CycloneCanSat/Random-Files/18.PNG

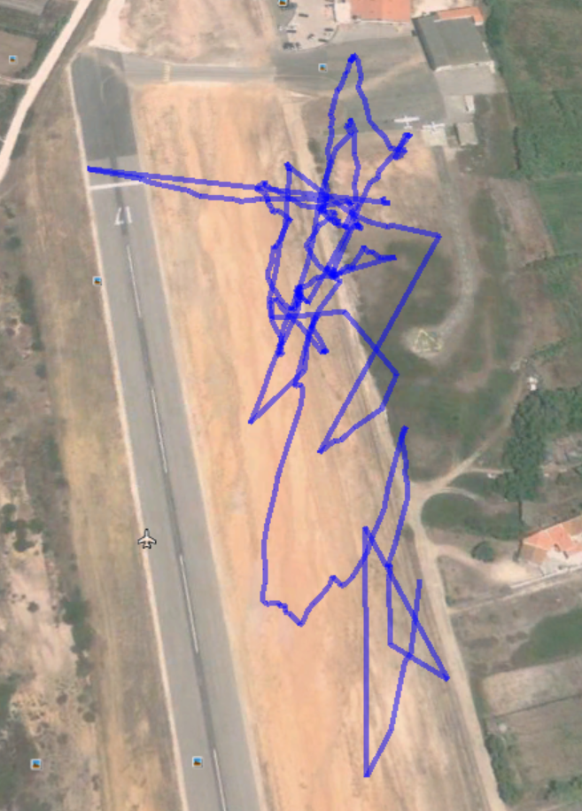
18.PNG
