CycloneCanSat/Random-Files/photo_2015-06-19_02-48-39.jpg

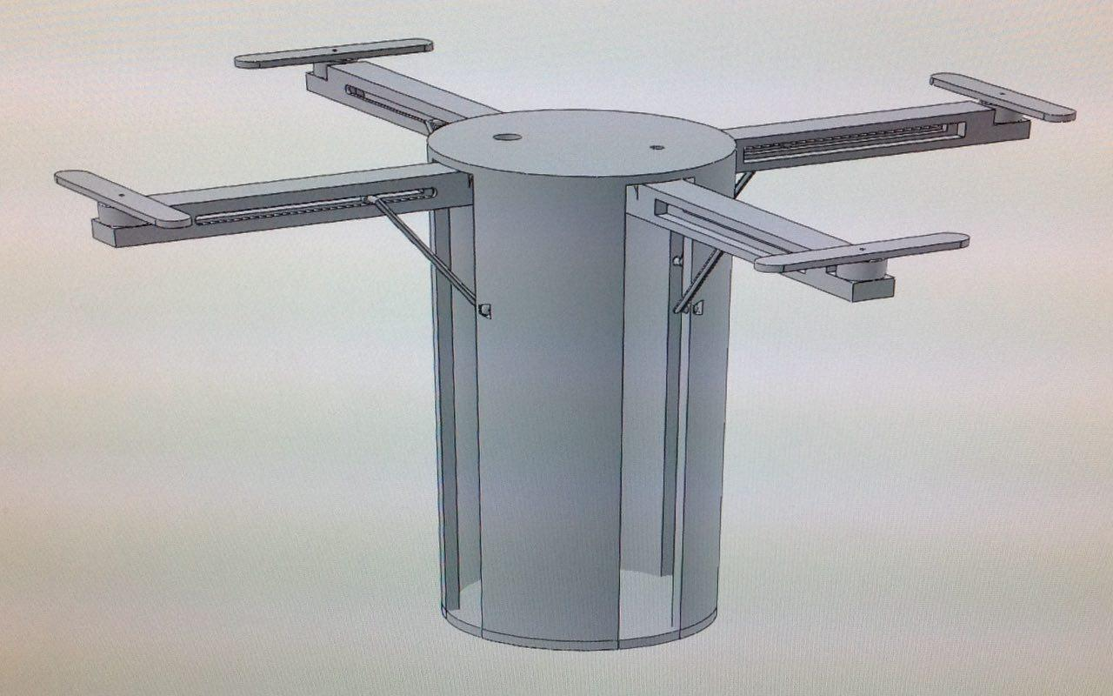
photo_2015-06-19_02-48-39.jpg
