CycloneCanSat/Random-Files/README.md

# Random-Files
These are random files from the Cyclone Team
