CycloneCanSat/Random-Files/Presentation2.pptx

Motor 4

ESC 1

IMU

Power Distribution Board

Main PCB

Motor 3

ESC 2

GPS

Motor 2

ESC 3

Battery

Mini FPV Camera

Humidity Sensor

Pressure Sensor

Motor 1

ESC 4

OSD

Control Board

FPV TX

Radio RX
