CycloneCanSat/Random-Files/Gantt Chart.docx

| | | | | | | | | | | | | | | | | | | | | | LAUNCH WEEK
| Week Commencing: | 19/10/2015 | 26/10/2015 | 02/11/2015 | 09/11/2015 | 16/11/2015 | 23/11/2015 | 30/11/2015 | 07/12/2015 | 14/12/2015 | 28/12/2015 | 04/01/2016 | 11/01/2016 | 18/01/2016 | 25/01/2016 | 01/02/2016 | 08/02/2016 | 15/02/2016 | 22/02/2016 | 29/02/2016 | 07/03/2016 | 14/03/2016 | 21/03/2016 | 28/03/2016
Electronics
| Sensor PCB design
| Sensor PCB assembly
| Quadcopter electronics assembly
| Camera system assembly
| Full can assembly
Software
| Write libraries for sensor
| Write libraries for RF98W
| Write Can code
Mechanics
| Layer design (using CAD)
| Arm design (using CAD)
| Layer manufacture (using 3D printing)
| Arm manufacture (using 3D printing)
| Manufacture of arm opening system
| Can assembly
Testing
| PCB testing
| Quadcopter system testing
| Camera system testing
| Full electronics testing
| Test arm opening
| Flight test
| Launch procedure testing
Outreach
| iOS app design
| Fundraising
| Talks to primary school students
| Inside school promotion
Base Station
| Software
| Communications system design
| Base station electronics design
| Base station electronics manufacture
Paperwork
| Progress Reports
| Submission of documentation to sponsors
