CycloneCanSat/Random-Files/hobbyking.pdf

Name | Quantity Cost per Unit Link | Sub-Total
Turnigy Nano-Tech 850mAh LiPo | 4 £ | 6.56 http://www.hobbyking.co.uk/hobbyking/store/__18203__Turnigy_nano_tech_850mAh_3S_45_90C_Lipo_Pack.html | £ 26.24
Hobbyking i8 Control Board | 1 £ 10.98 http://www.hobbyking.co.uk/hobbyking/store/__12974__Hobbyking_i86_Multi_Rotor_Control_Board.html | £ 10.98
Turnigy Multistar Outrunner V2 Motors | 6 £ | 7.46 http://www.hobbyking.co.uk/hobbyking/store/__66414__Turnigy_Multistar_1704_1900Kv_12_Pole_Multi_Rotor_Outrunner_V2.htmlv | £ 44.76
Turnigy Multistar 20A Slim ESCs | 6 £ | 8.88 http://www.hobbyking.com/hobbyking/store/__65154__Turnigy_Multistar_20A_Slim_V2_ESC_With_BLHeli_OPTO_2_6S.html | £ 53.28
Turnigy Analog Nano Servos | 6 £ | 2.55 http://www.hobbyking.com/hobbyking/store/__28280__Turnigy_8482_TGY_TS531A_Analog_Nano_Servo_0_5kg_0_12sec_3_7g.html | £ 15.30
Hobbyking FPV Transmitter | 2 £ 13.35 http://hobbyking.com/hobbyking/store/__76392__HobbyKing_8482_FT952_5_8GHz_32CH_200mW_Mini_FPV_Transmitter_with_Gopro_3_AV_Lead.html | £ 26.70
Turnigy 2200mAh battery (for base station) | 2 £ | 6.39 http://hobbyking.com/hobbyking/store/__8932__Turnigy_2200mAh_3S_20C_Lipo_Pack.html | £ 12.78
SkyZone FPV receiver | 2 £ 12.77 http://hobbyking.com/hobbyking/store/__18649__SkyZone_RC805_5_8Ghz_8_Channel_AV_Receiver.html | £ 25.54
Polarized SMA antenna | 2 £ | 3.19 http://hobbyking.com/hobbyking/store/__43700__5_8GHz_Circular_Polarized_Antenna_SMA_Set_Short_.html | £ 6.38
SMA wire | 5 £ | 1.06 http://hobbyking.com/hobbyking/store/uh_viewItem.asp?idProduct=50463 | £ 5.30
Hobbyking OSD | 2 £ | 9.28 http://hobbyking.com/hobbyking/store/__16662__HobbyKing_E_OSD.html | £ 18.56
Mini FPV Camera | 2 £ 18.84 http://hobbyking.com/hobbyking/store/__64444__Mini_CMOS_FPV_Camera_520TVL_90_deg_Field_Of_Vision_0_008LUX_11_5_x_11_5_x_21mm_PAL_.html | £ 37.68
Lipol Bags | 6 £ | 1.34 http://hobbyking.com/hobbyking/store/__27105__Lipoly_Charge_Bag_23_x_30cm.html | £ 8.04
Orange Radio Transmitter | 1 £ 41.59 http://www.hobbyking.co.uk/hobbyking/store/__54822__OrangeRx_T_SIX_2_4GHz_DSM2_Compatible_6CH_Transmitter_w_10_Model_Memory_and_3_Pos_Switch_Mode_2_.html | £ 41.59
Orange Radio Receiver | 2 £ | 6.97 http://www.hobbyking.co.uk/hobbyking/store/__61211__OrangeRx_R410X_DSMX_Compatible_4Ch_6CH_PWM_CPPM_2_4Ghz_Receiver_.html | £ 13.94
Hobbyking LiPo charger | 1 £ | 7.98 http://hobbyking.com/hobbyking/store/__21044__Hobbyking_174_DC_4S_Balance_Charger_Cell_Checker_30w_2s_4s.html | £ 7.98
TOTAL | £ 355.05
