CycloneCanSat/Random-Files/13.PNG

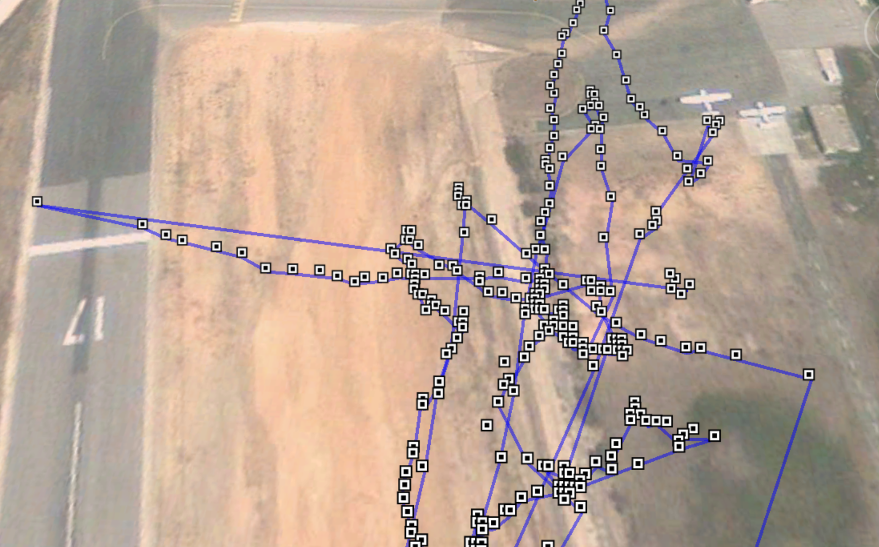
13.PNG
