CycloneCanSat/Random-Files/14.PNG

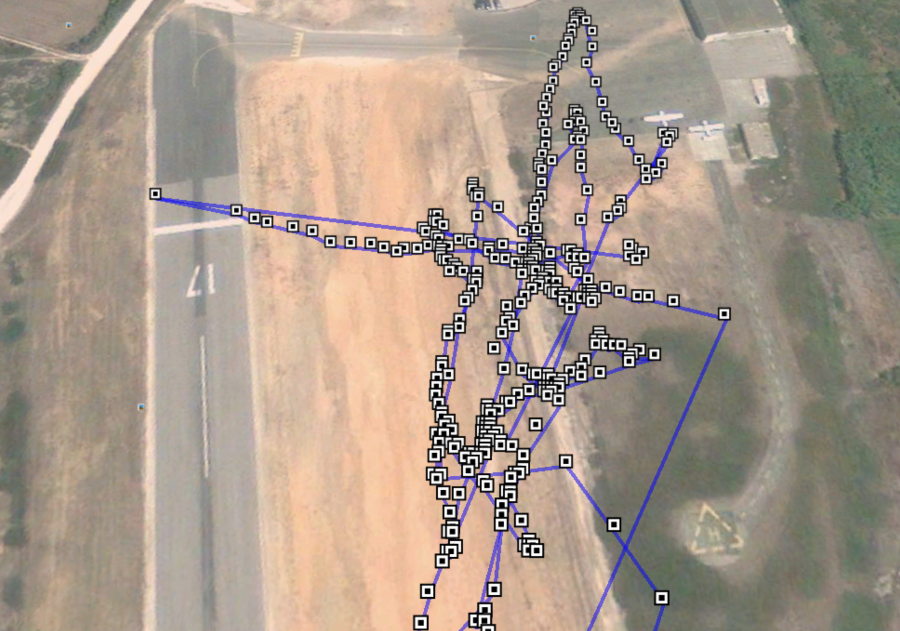
14.PNG
