CycloneCanSat/Random-Files/15.PNG

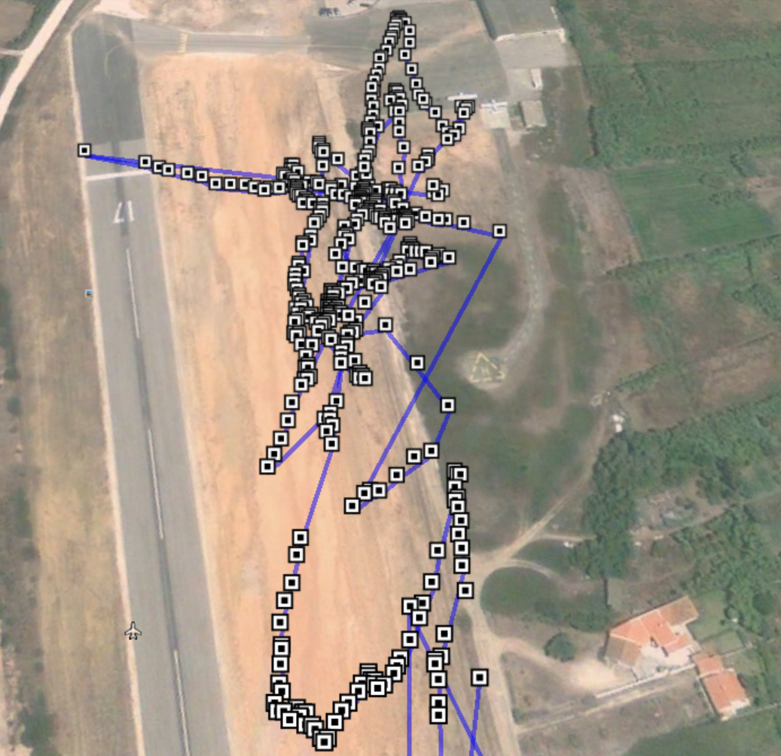
15.PNG
