CycloneCanSat/Random-Files/16.PNG

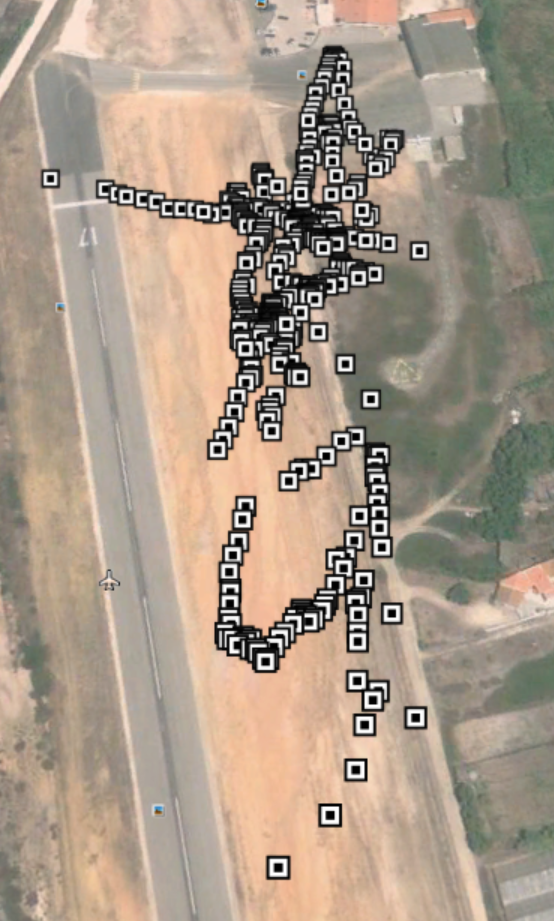
16.PNG
