CycloneCanSat/Random-Files/17.PNG

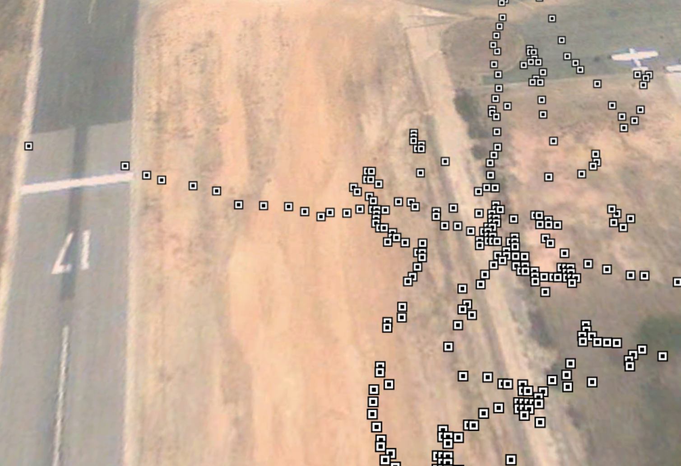
17.PNG
