CycloneCanSat/Random-Files/19.PNG

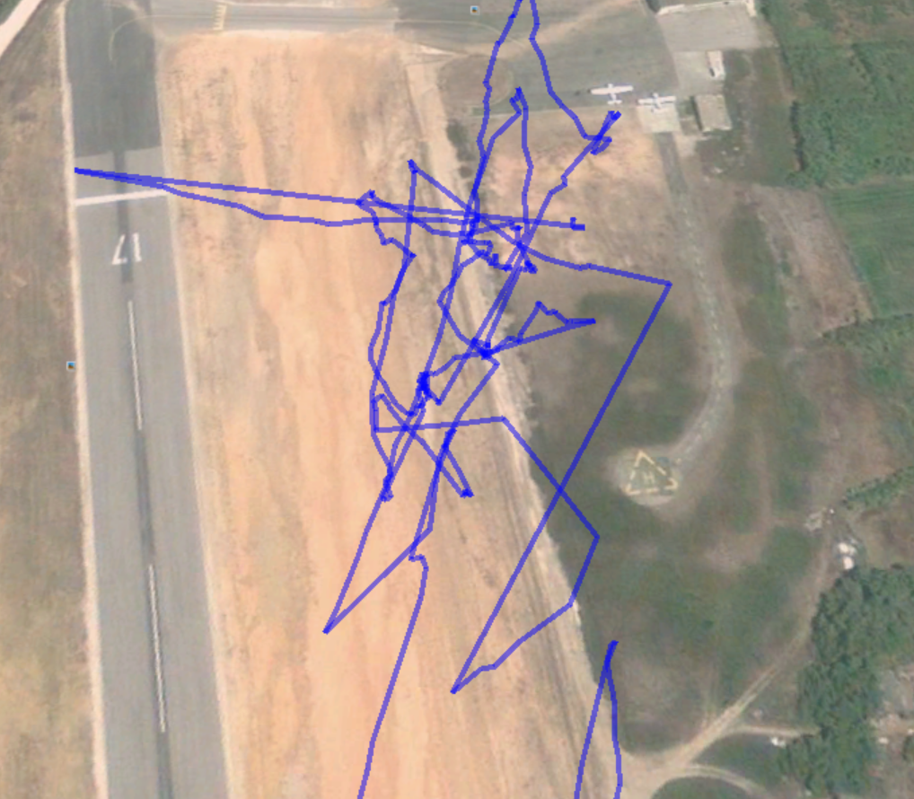
19.PNG
