CycloneCanSat/Random-Files/22.PNG

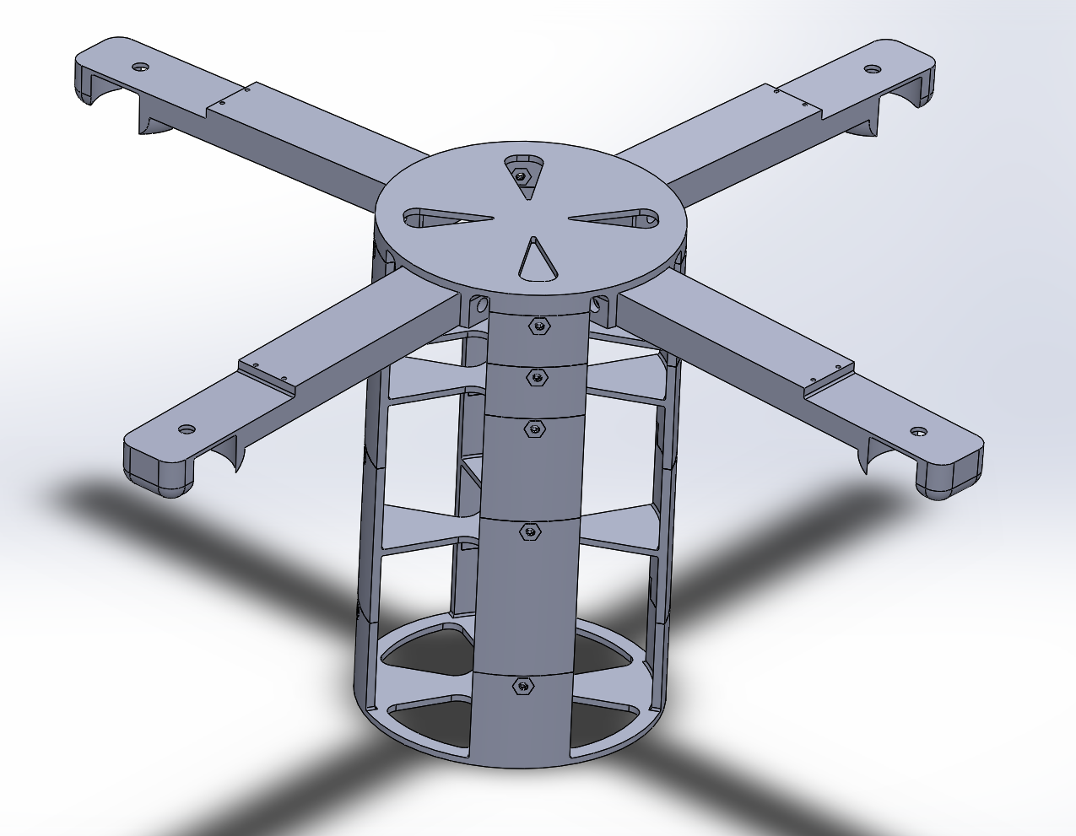
22.PNG
