CycloneCanSat/Random-Files/23.PNG

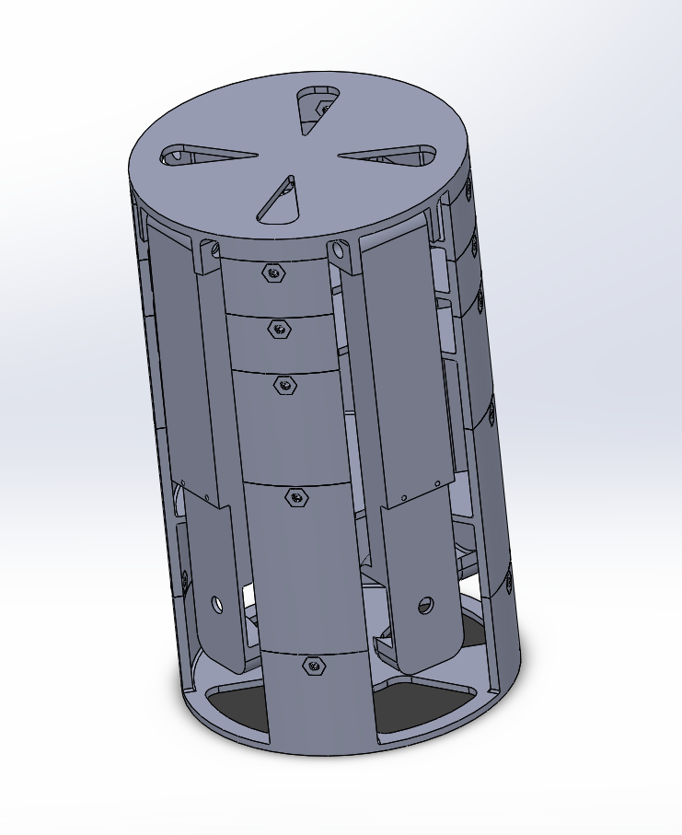
23.PNG
