CycloneCanSat/Random-Files/24.PNG

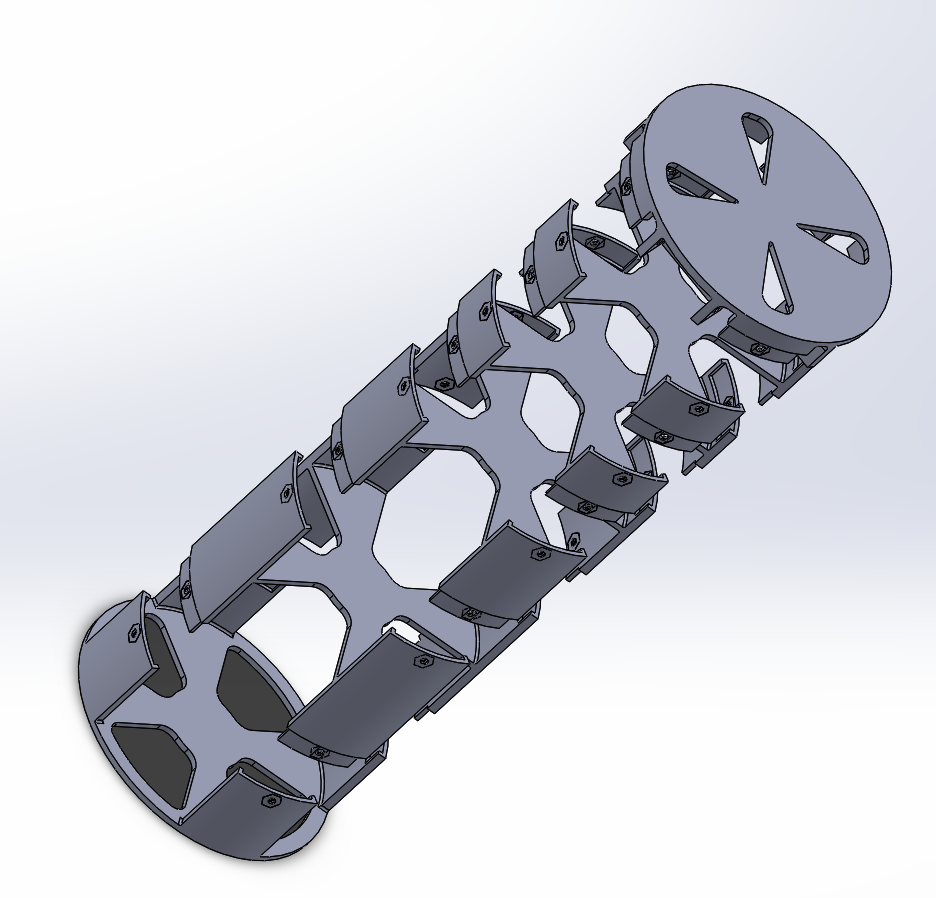
24.PNG
