CycloneCanSat/Random-Files/25.PNG

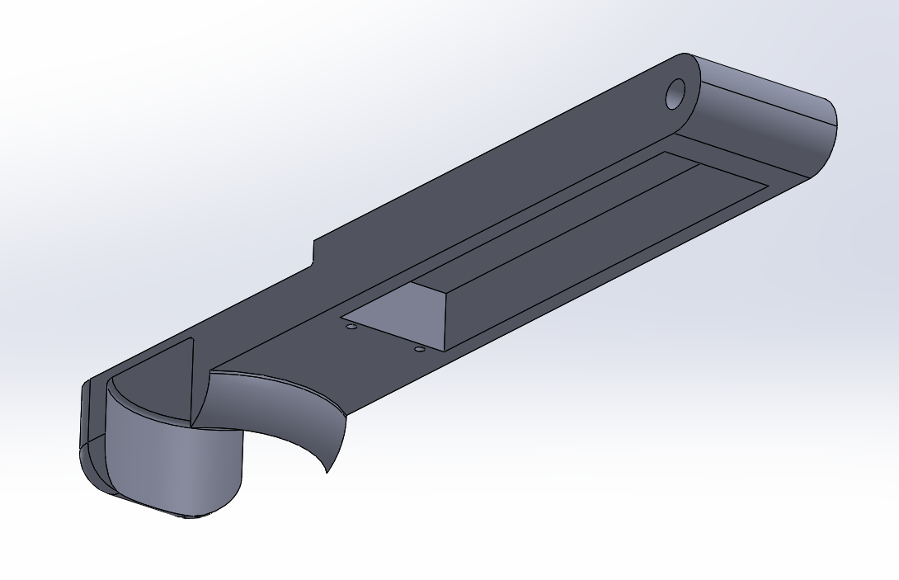
25.PNG
