CycloneCanSat/Random-Files/26.PNG

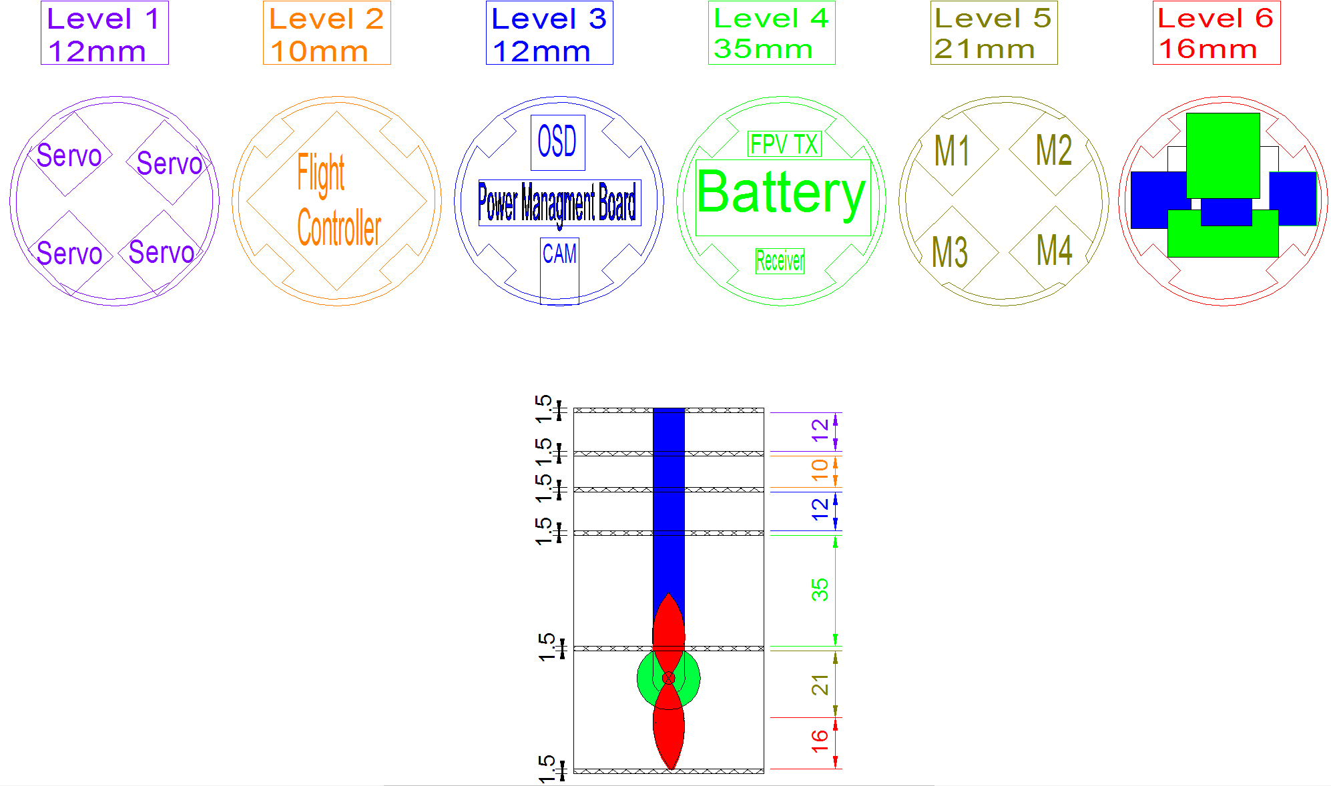
26.PNG
