CycloneCanSat/Random-Files/Capture2.PNG

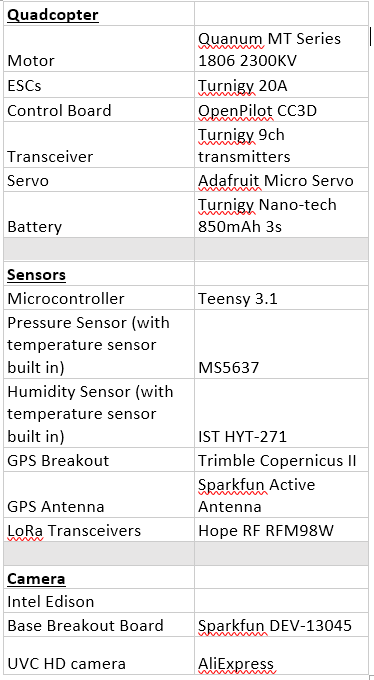
Capture2.PNG
