CycloneCanSat/Random-Files/Capture4.PNG

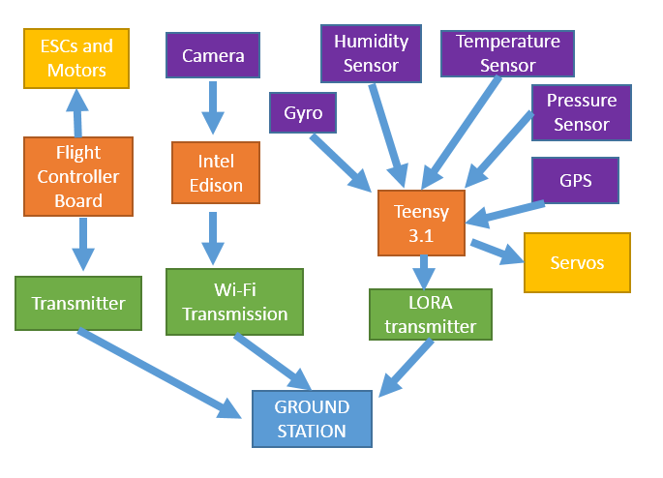
Capture4.PNG
