CycloneCanSat/Random-Files/Capture5.PNG

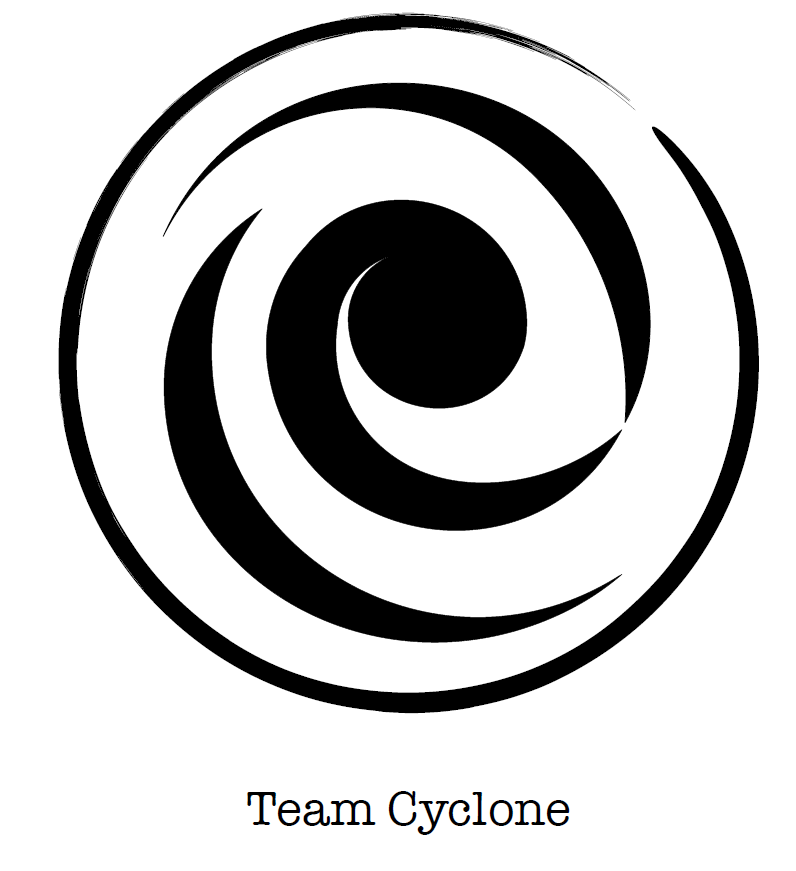
Capture5.PNG
