CycloneCanSat/Random-Files/Capture6.PNG

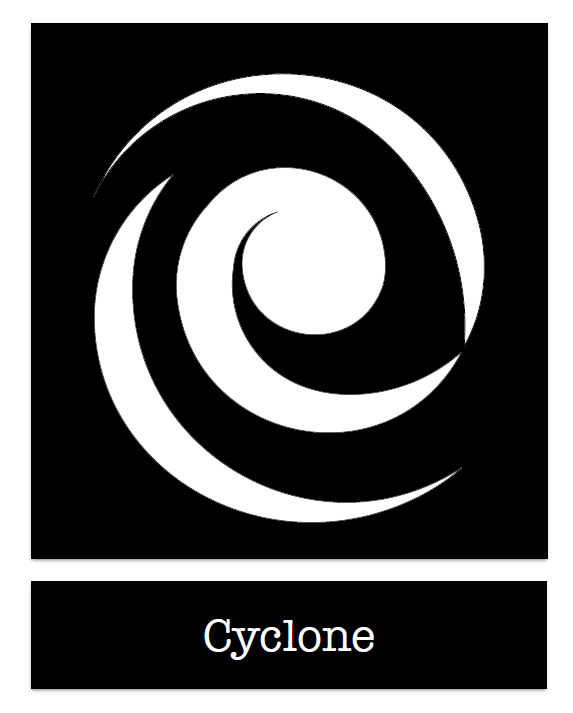
Capture6.PNG
