CycloneCanSat/Random-Files/Capture7.PNG

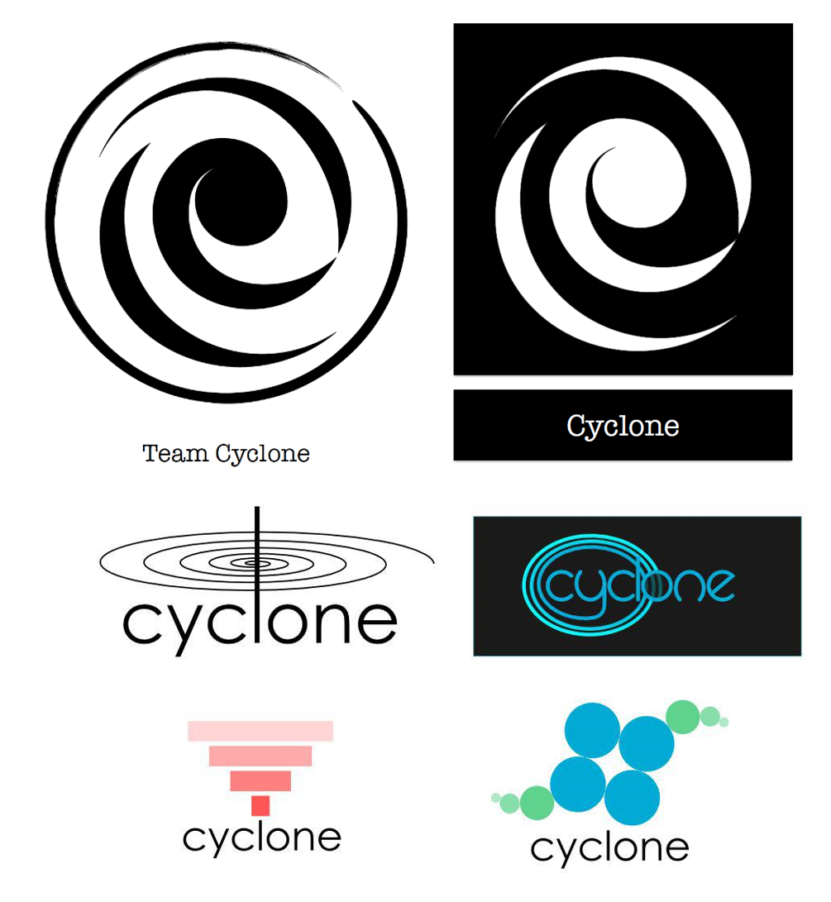
Capture7.PNG
