CycloneCanSat/Random-Files/Capture11.PNG

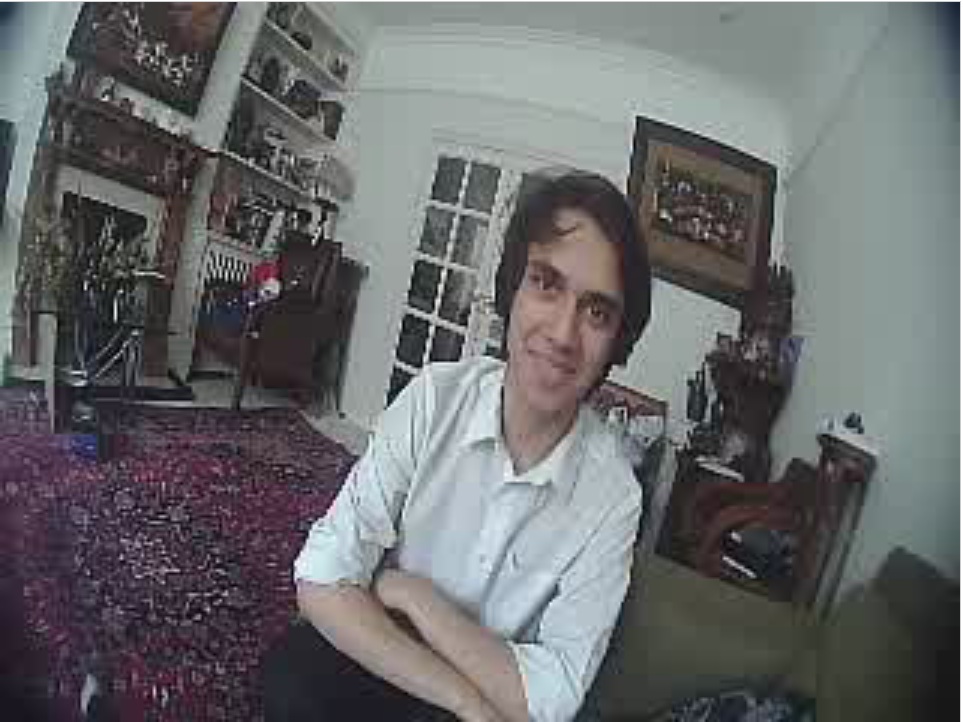
Capture11.PNG
