CycloneCanSat/Random-Files/Capture12.PNG

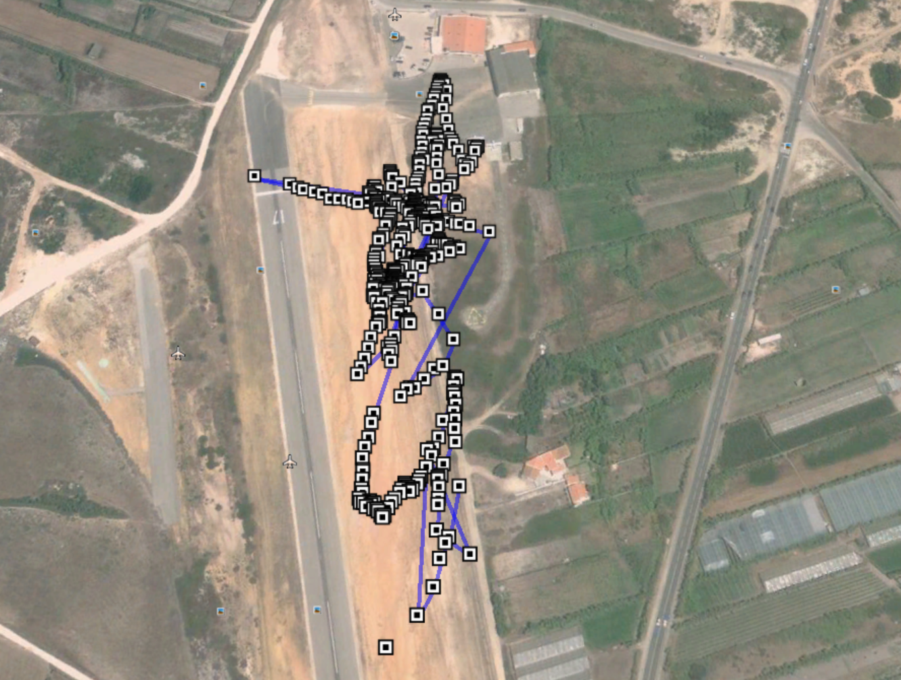
Capture12.PNG
