CycloneCanSat/Random-Files/Capture13.jpg

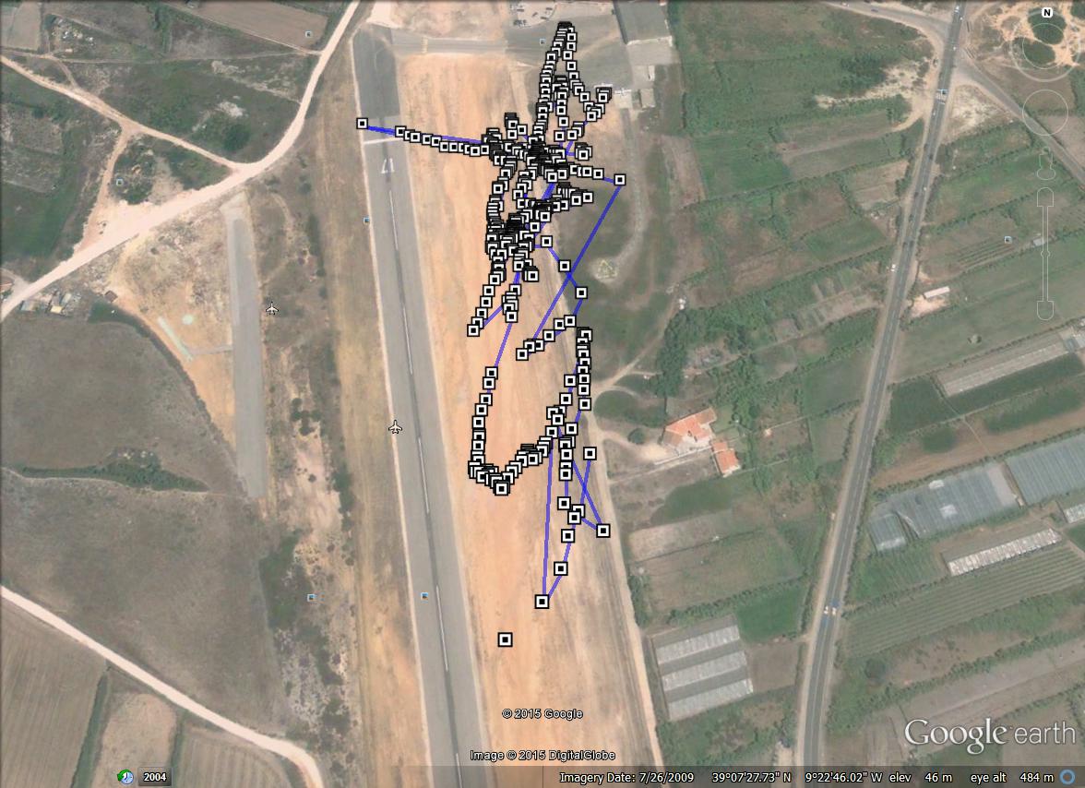
Capture13.jpg
