CycloneCanSat/Random-Files/capture14.jpg

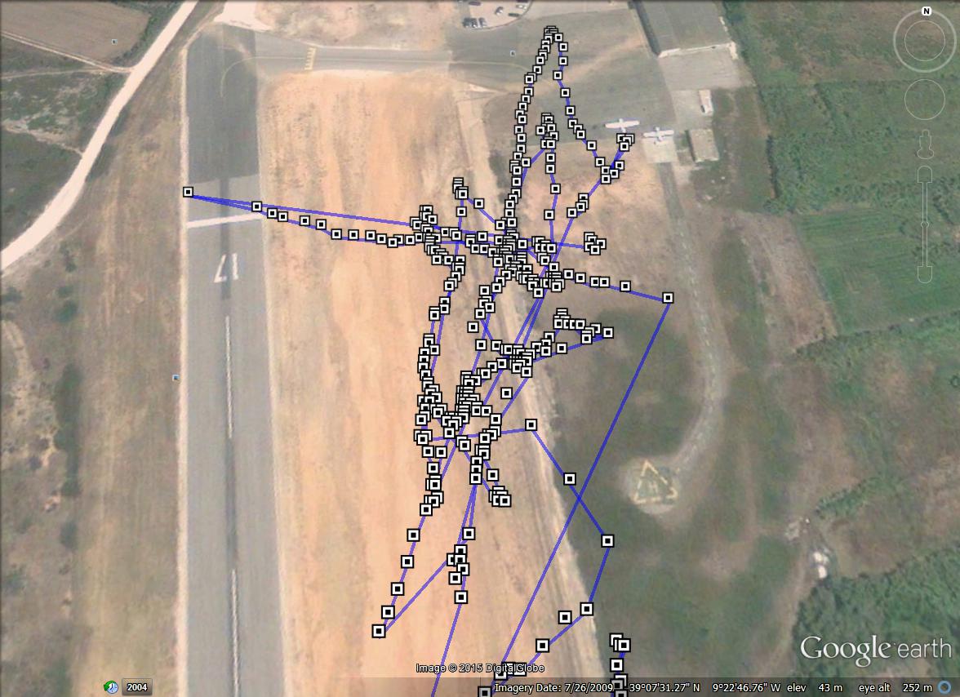
capture14.jpg
