CycloneCanSat/Random-Files/Capture.PNG

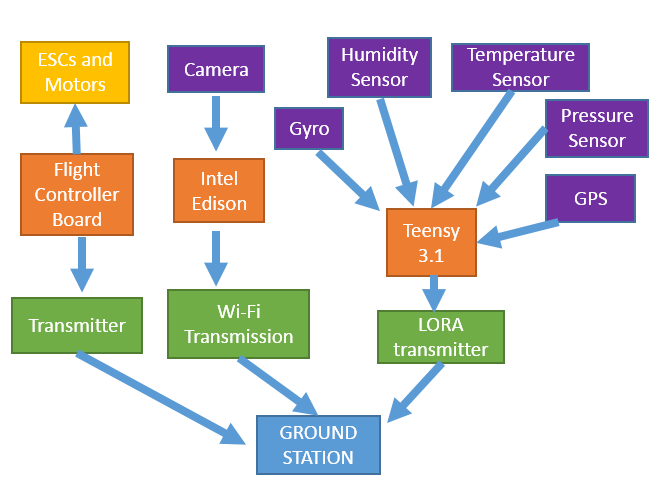
Capture.PNG
