CycloneCanSat/Random-Files/CircuitDiagram.png

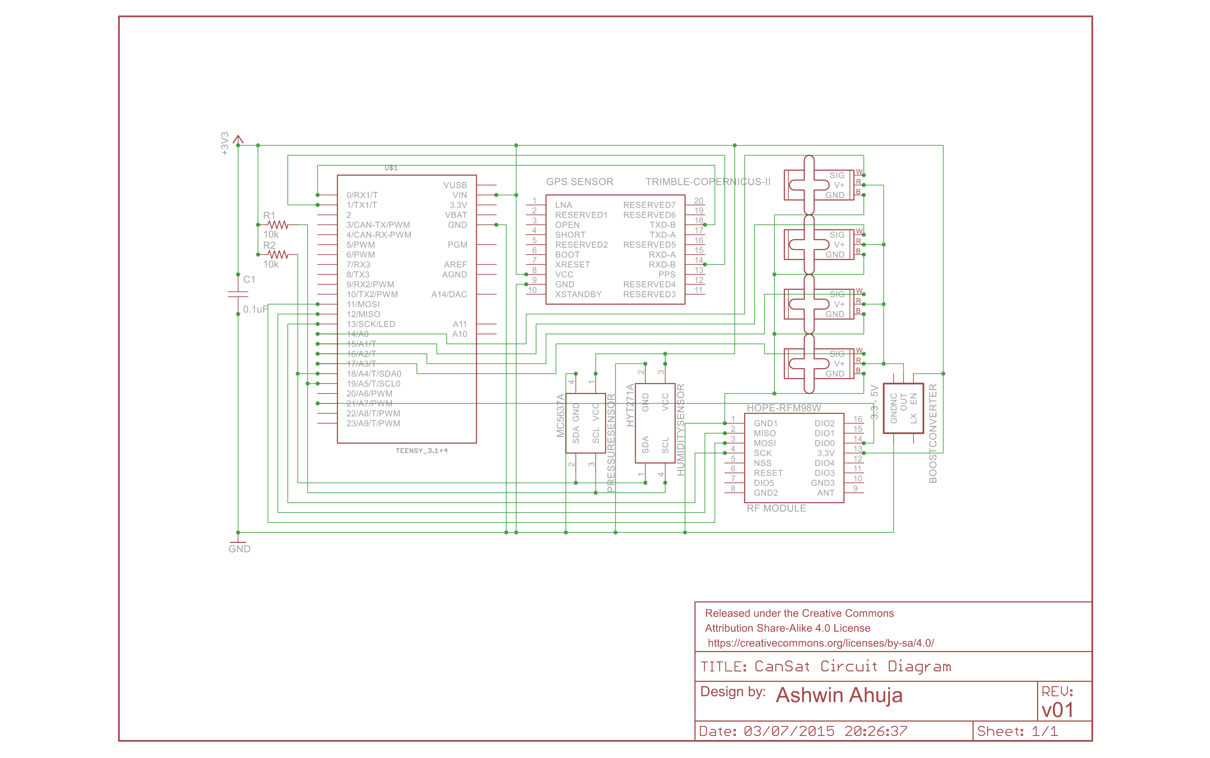
CircuitDiagram.png
