CycloneCanSat/Random-Files/Colossus.PNG

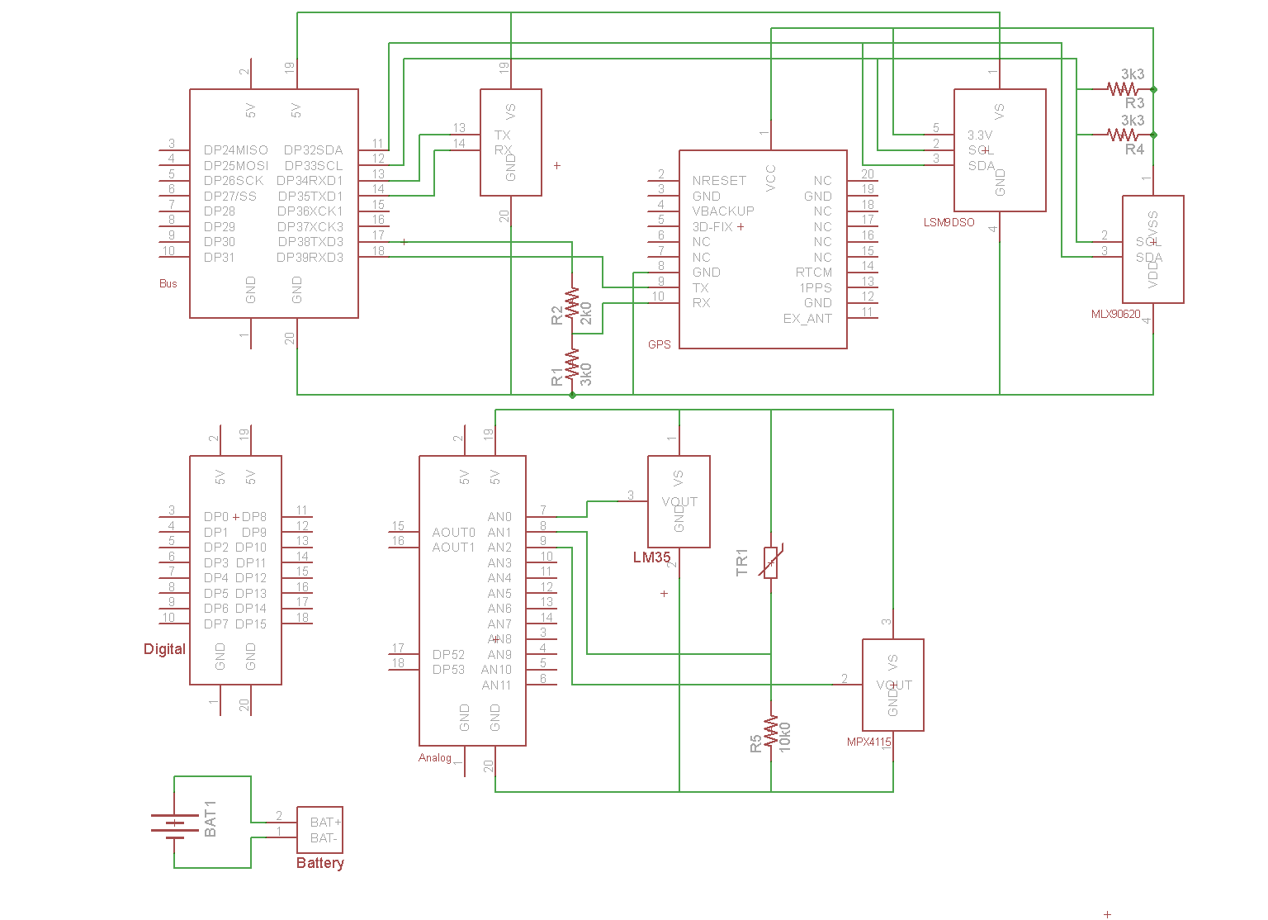
Colossus.PNG
