CycloneCanSat/Random-Files/FISH1.PNG

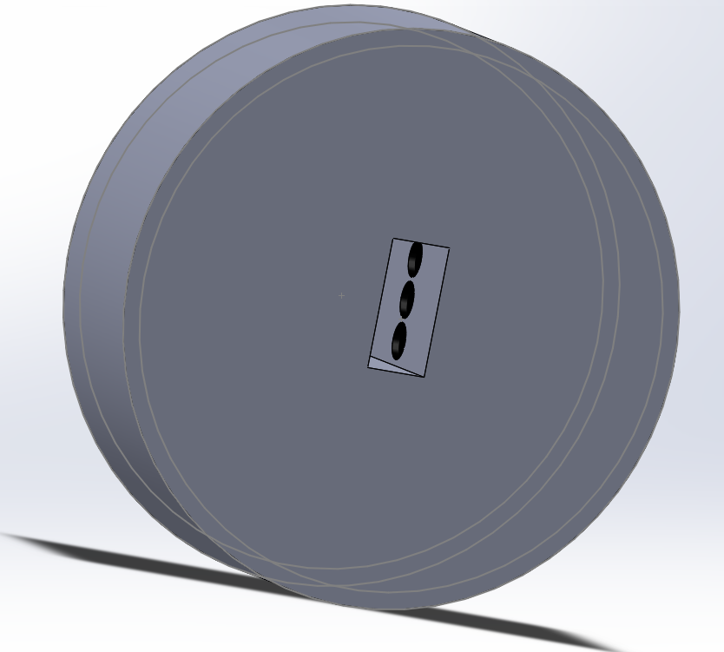
FISH1.PNG
