CycloneCanSat/Random-Files/FISH2.PNG

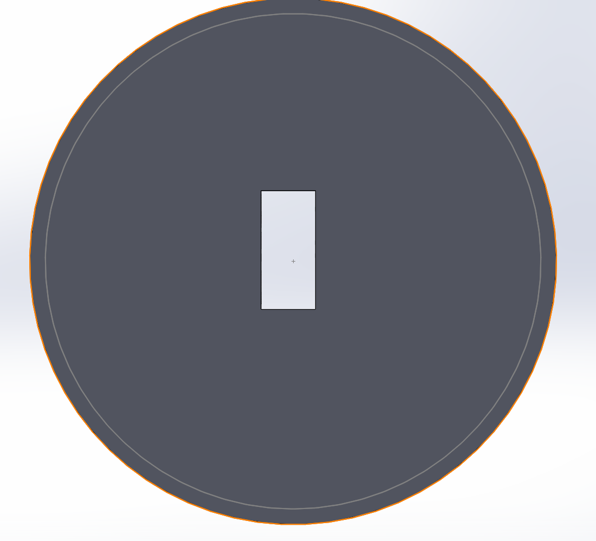
FISH2.PNG
