CycloneCanSat/Random-Files/FISH3.PNG

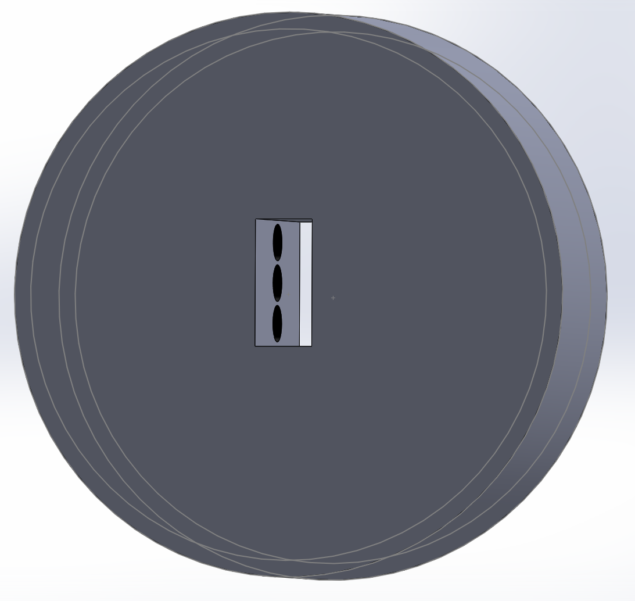
FISH3.PNG
