CycloneCanSat/Random-Files/photo_2015-06-19_02-48-59.jpg

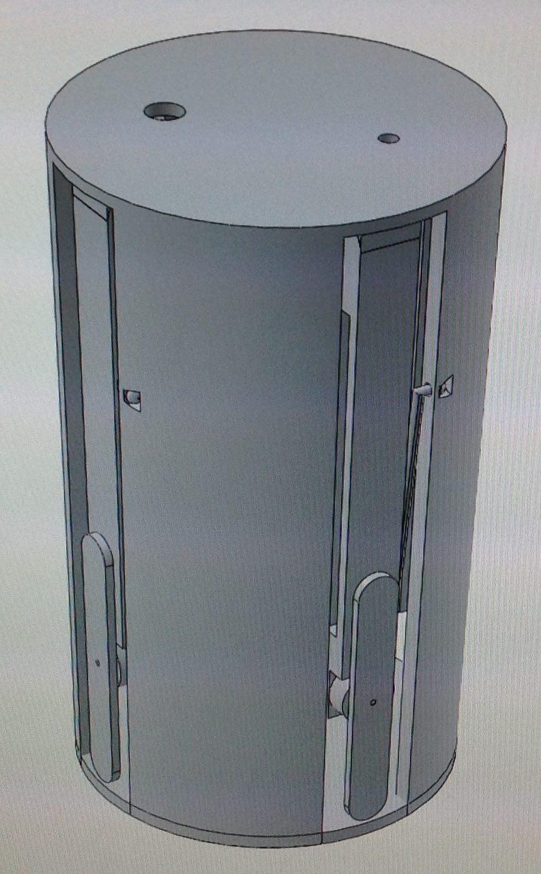
photo_2015-06-19_02-48-59.jpg
