CycloneCanSat/Random-Files/Presentation1.png

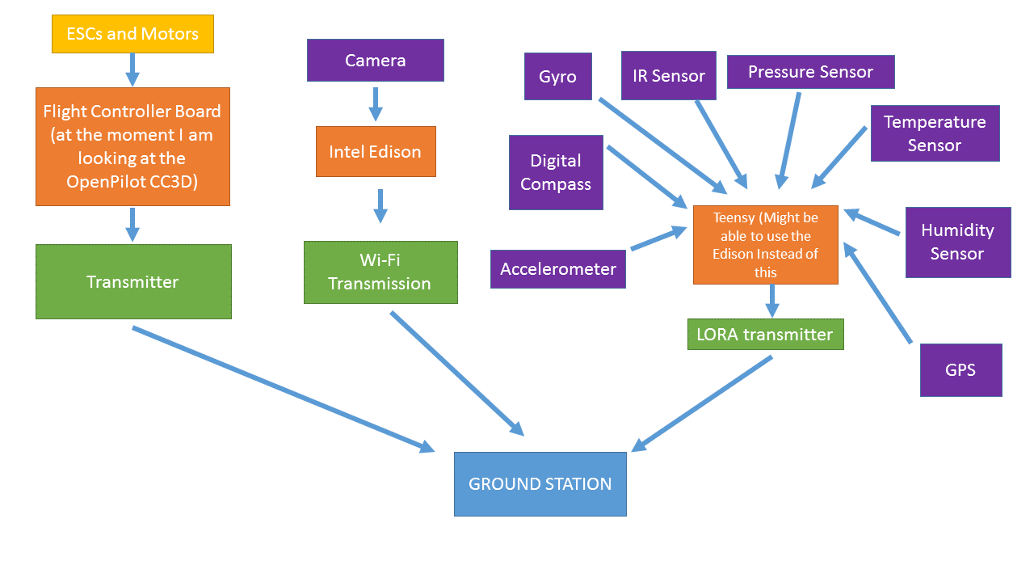
Presentation1.png
