CycloneCanSat/Random-Files/Presentation2/Slide1.JPG

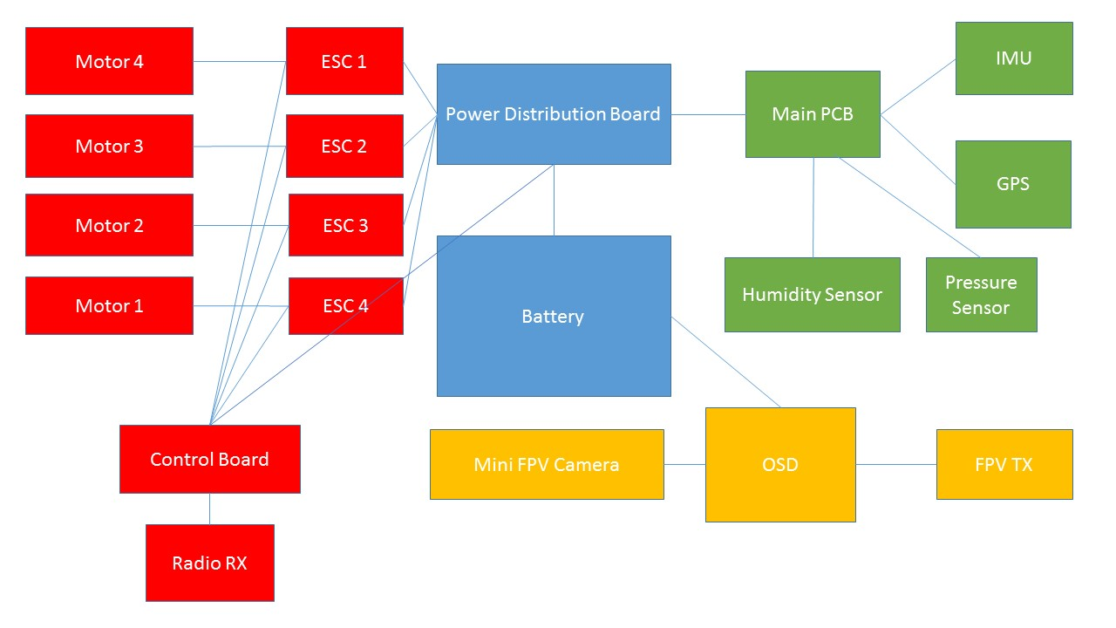
Presentation2/Slide1.JPG
