CycloneCanSat/Random-Files/y.png

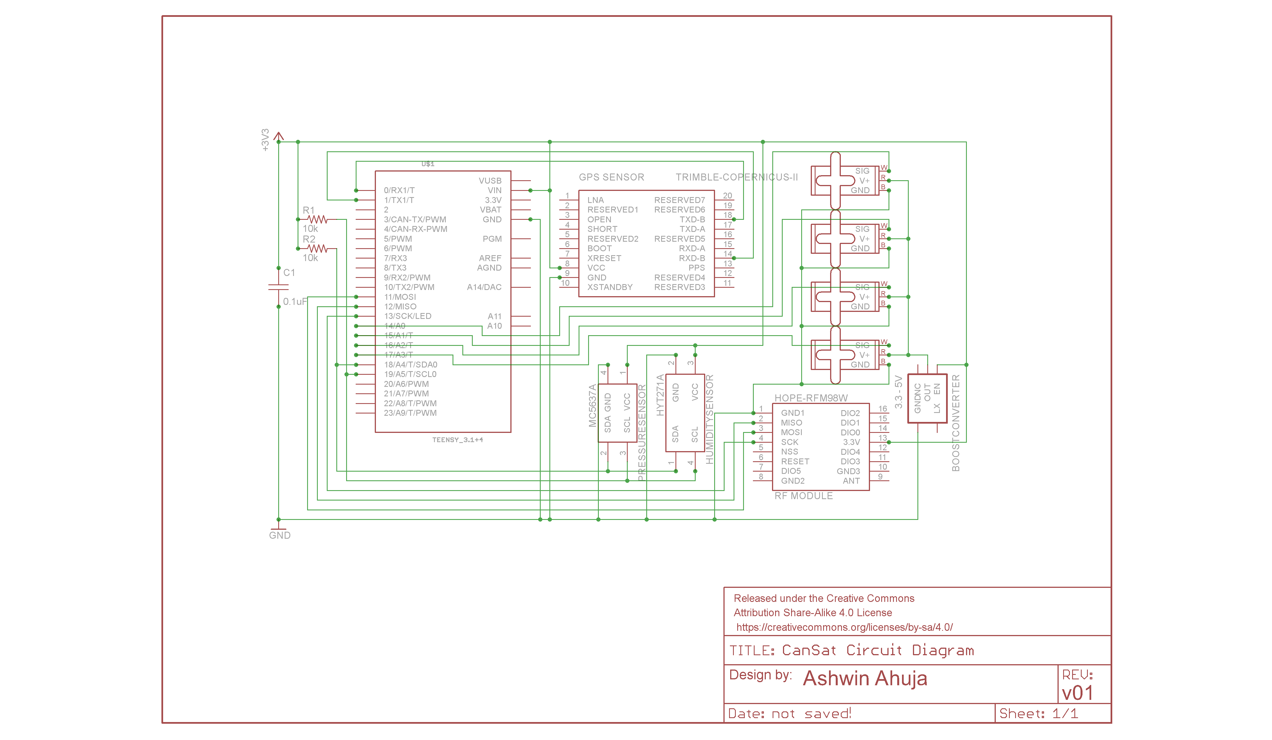
y.png
