CycloneCanSat/Random-Files/Book1.xlsx

 | Model | Price | Link
Quadcopter
Motor | Quanum MT Series 1806 2300KV | £7 | http://www.hobbyking.co.uk/hobbyking/store/__66404__Quanum_MT_Series_1806_2300KV_Brushless_Multirotor_Motor_Built_by_DYS.html
ESCs | Turnigy 20A | £9 | http://www.hobbyking.co.uk/hobbyking/store/__65154__Turnigy_Multistar_20A_Slim_V2_ESC_With_BLHeli_OPTO_2_6S.html
Control Board (preferably with barometer) | OpenPilot CC3D | £15 | http://www.hobbyking.co.uk/hobbyking/store/__65885__Openpilot_CC3D_Flight_Controller_With_Cable_Set_Fully_Authorized.html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
Transceiver
Servo | Adafruit Micro Servo |  | https://www.adafruit.com/products/1143
Battery | Zippy Compact 850mAh 3s
Sensors
Microcontroller | Teensy 3.1 | $20 | http://pjrc.com/store/teensy31.html
Pressure Sensor (with temperature sensor built in) | MS5637 | £4 | http://www.digikey.co.uk/product-detail/en/MS563702BA03-50/223-1199-1-ND/4700922
Humidity Sensor (with temperature sensor built in) | IST HYT-271 | £26.50 | http://www.digikey.co.uk/en/product-highlight/m/measurement-specialties/ms5637-pressure-sensor
GPS | GP-635T | $40 | https://www.sparkfun.com/products/11571
LoRa Transceivers | Hope RF RFM98W | £10 | http://www.hoperf.co.uk/shop/RFM98W-433S2-RFM98W_433S2.html
Camera
Intel Edison |  | $50 | https://www.sparkfun.com/products/13024
Base Breakout Board | Sparkfun DEV-13045 | $32 | https://www.sparkfun.com/products/13045
UVC HD camera | AliExpress | $28 | http://www.aliexpress.com/item/1080p-hd-mini-micro-camera-mjpeg-usb2-0-uvc-webcam-module-ELP-USBFHD01M-L36/32261191143.html
