CycloneCanSat/Random-Files/Assem1.SLDASM

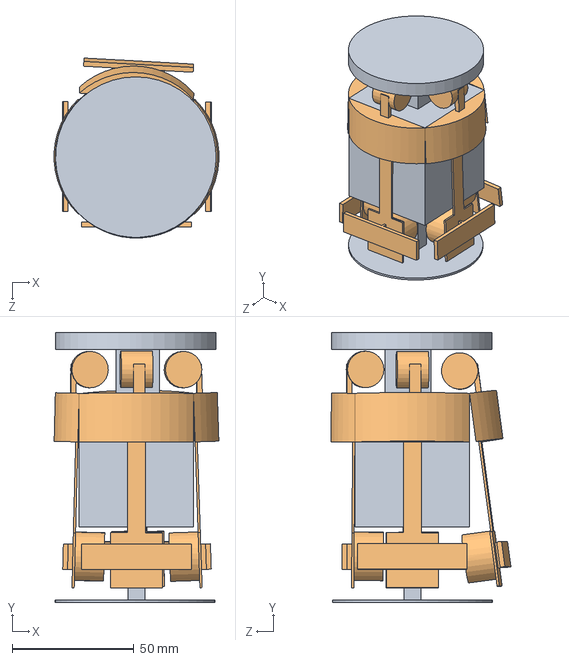
[picture p183: CAD file, 2015-10-06]
Assem1.SLDASM
67.7 x 111.0 x 74.0 mm
