CycloneCanSat/Random-Files/Assem2.SLDASM

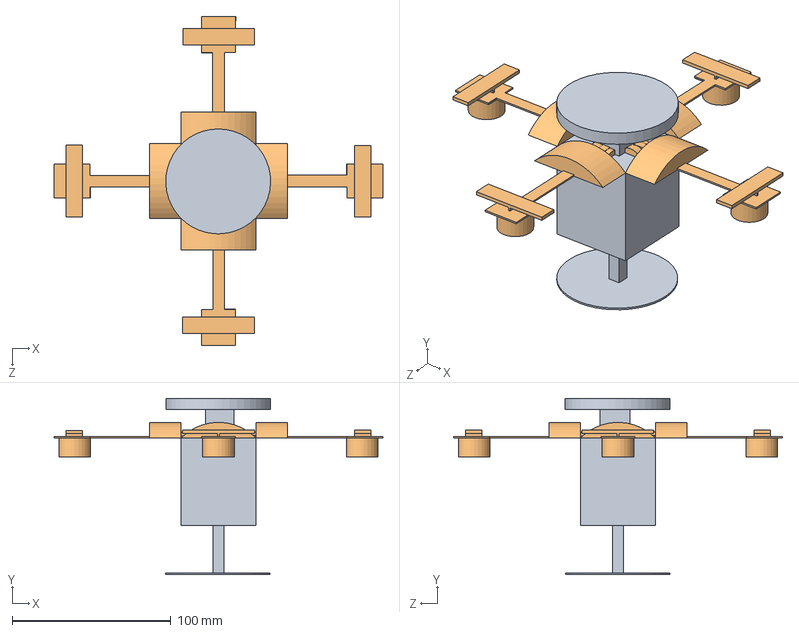
[picture p184: CAD file, 2015-10-06]
Assem2.SLDASM
207.0 x 111.0 x 207.1 mm
