CycloneCanSat/Random-Files/Assemrotated.SLDASM

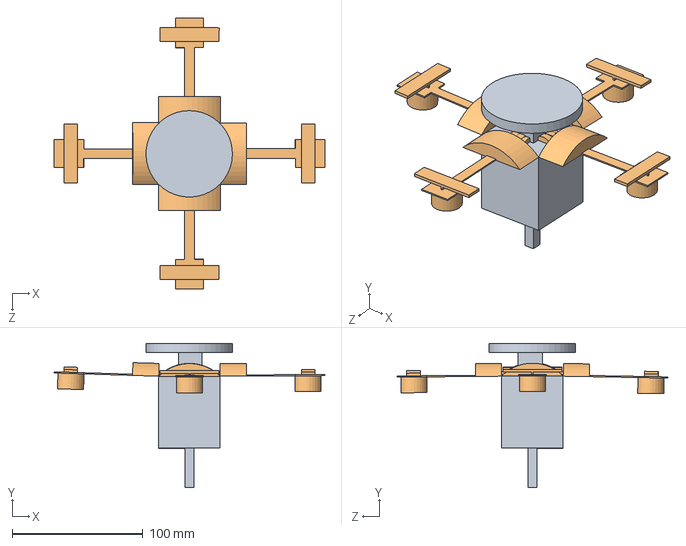
[picture p185: CAD file, 2015-10-06]
Assemrotated.SLDASM
207.0 x 110.0 x 207.1 mm
