CycloneCanSat/Random-Files/Part2.SLDPRT

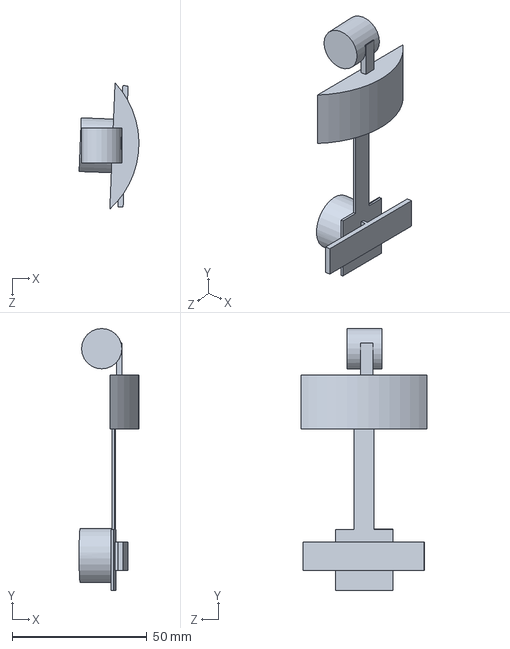
[picture p186: CAD file, 2015-10-06]
Part2.SLDPRT
22.3 x 97.4 x 47.0 mm
