CycloneCanSat/Random-Files/Part1.SLDPRT

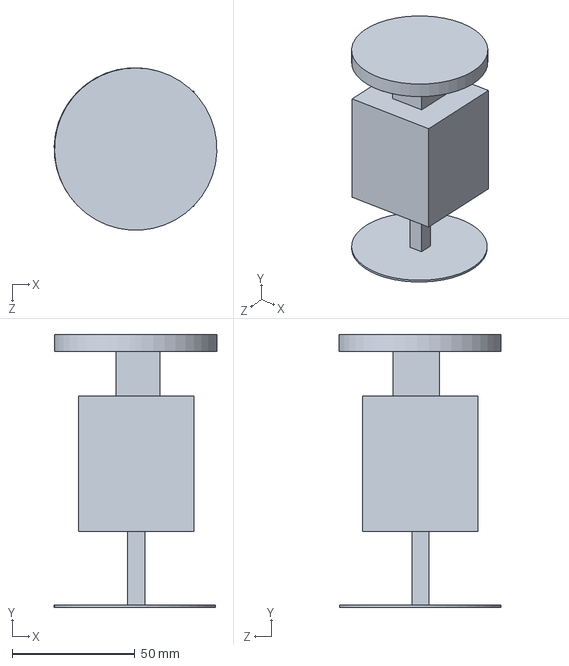
[picture p187: CAD file, 2015-10-06]
Part1.SLDPRT
66.1 x 111.0 x 66.1 mm
