CycloneCanSat/Random-Files/CanSat Circuit Diagram.sch

## EAGLE design CanSat Circuit Diagram.sch (2015-10-06)

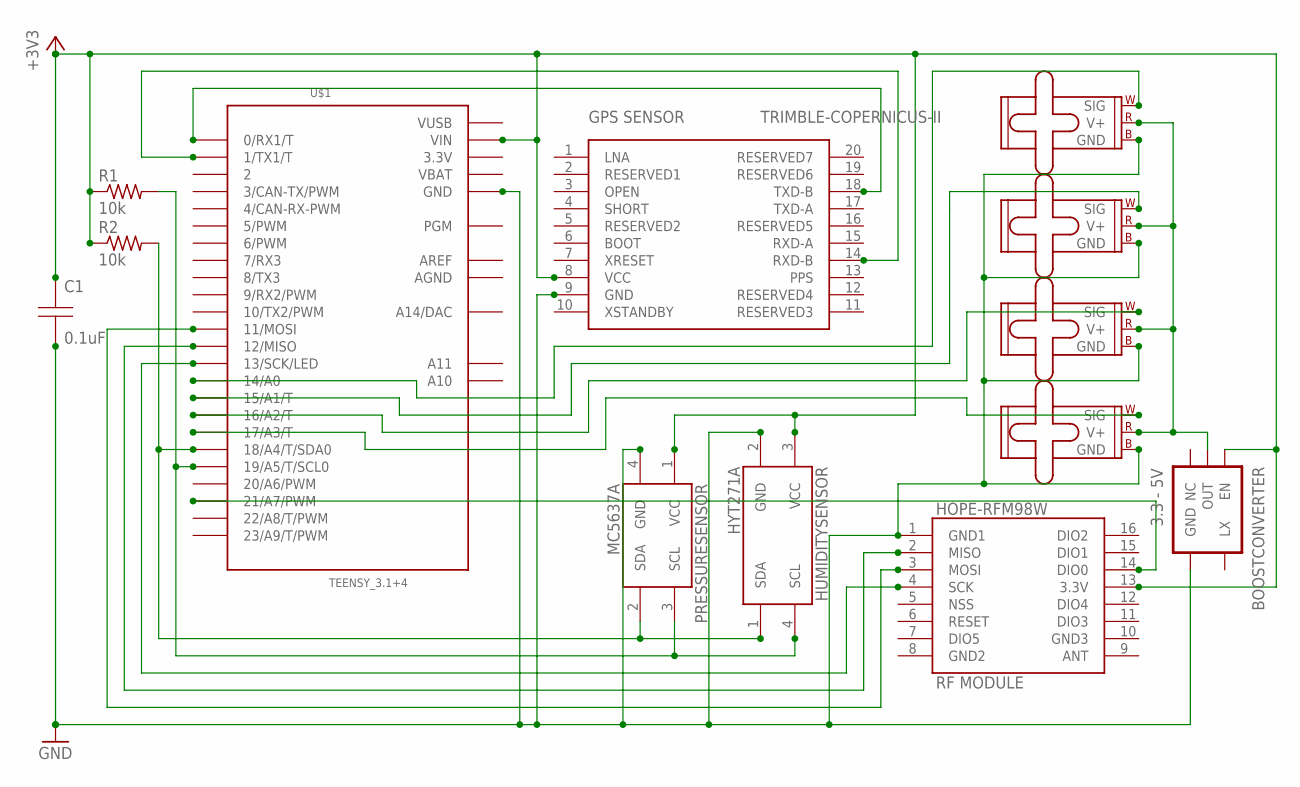
[picture p188: schematic CanSat Circuit Diagram.sch]

Parts:
BOOSTCONVERTER: 3.3 - 5V; SOT23-5
C1: 0.1uF; C0805
HOPE-RFM98W: RF MODULE; HOPE
HUMIDITYSENSOR: HYT271A; HYT271
M1, M2, M3, M4: SMALL_SERVO; 1X03
PRESSURESENSOR: MC5637A; MS5637
R1, R2: 10k; 0805-THM
TRIMBLE-COPERNICUS-II: GPS SENSOR; COPERNICUS-DIP
U$1: TEENSY_3.1+4

Connections:
+3V3: BOOSTCONVERTER.1 (EN), C1.1 (A), HOPE-RFM98W.13 (3.3V), HUMIDITYSENSOR.3 (VCC), PRESSURESENSOR.1 (VCC), R1.1, R2.1, TRIMBLE-COPERNICUS-II.8 (VCC), U$1.VIN
GND: BOOSTCONVERTER.4 (GND), C1.2 (B), HOPE-RFM98W.1 (GND1), HUMIDITYSENSOR.2 (GND), M1.3 (GND), M2.3 (GND), M3.3 (GND), M4.3 (GND), PRESSURESENSOR.4 (GND), TRIMBLE-COPERNICUS-II.9 (GND), U$1.GND
unnamed: TRIMBLE-COPERNICUS-II.18 (TXD-B), U$1.0 (0/RX1/T)
unnamed: TRIMBLE-COPERNICUS-II.14 (RXD-B), U$1.1 (1/TX1/T)
unnamed: HOPE-RFM98W.2 (MISO), U$1.12 (12/MISO)
unnamed: HOPE-RFM98W.3 (MOSI), U$1.11 (11/MOSI)
unnamed: HOPE-RFM98W.4 (SCK), U$1.13 (13/SCK/LED)
unnamed: BOOSTCONVERTER.2 (OUT), M1.2 (V+), M2.2 (V+), M3.2 (V+), M4.2 (V+)
unnamed: HUMIDITYSENSOR.1 (SDA), PRESSURESENSOR.2 (SDA), R2.2, U$1.18/A4 (18/A4/T/SDA0)
unnamed: HUMIDITYSENSOR.4 (SCL), PRESSURESENSOR.3 (SCL), R1.2, U$1.19/A5 (19/A5/T/SCL0)
unnamed: M3.1 (SIG), U$1.17/A3 (17/A3/T)
unnamed: M4.1 (SIG), U$1.16/A2 (16/A2/T)
unnamed: M2.1 (SIG), U$1.15/A1 (15/A1/T)
unnamed: M1.1 (SIG), U$1.14/A0
unnamed: HOPE-RFM98W.14 (DIO0), U$1.21/A7 (21/A7/PWM)
